rcmeng1q84/event-station/models/concept_Artboard 1.png

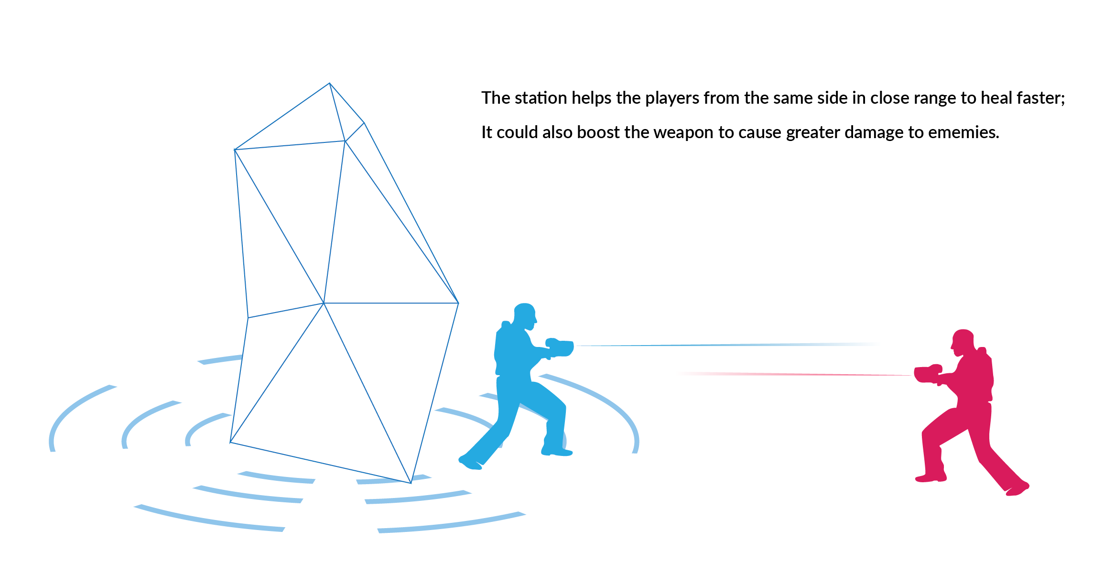
models/concept_Artboard 1.png
