rcmeng1q84/event-station/models/concept_Artboard 4.png

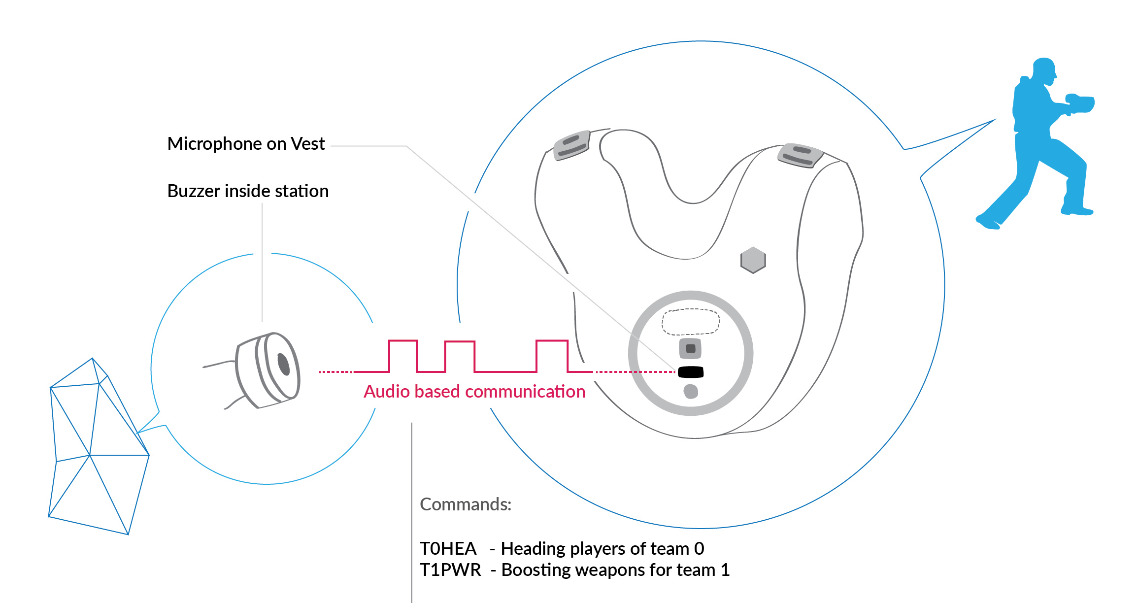
models/concept_Artboard 4.png
