rcmeng1q84/event-station/models/joints.jpg

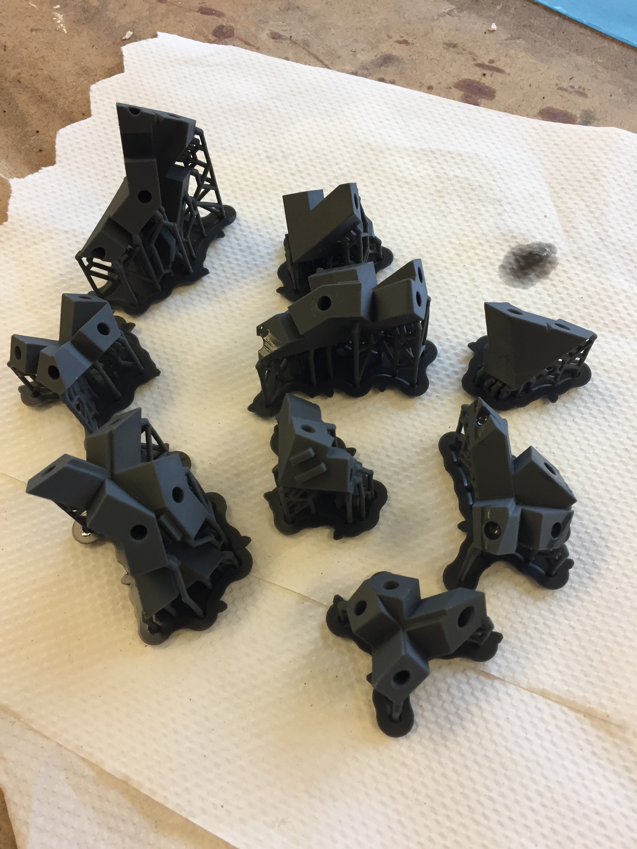
models/joints.jpg
