rcmeng1q84/event-station/models/Photo Dec 12, 18 39 48.jpg

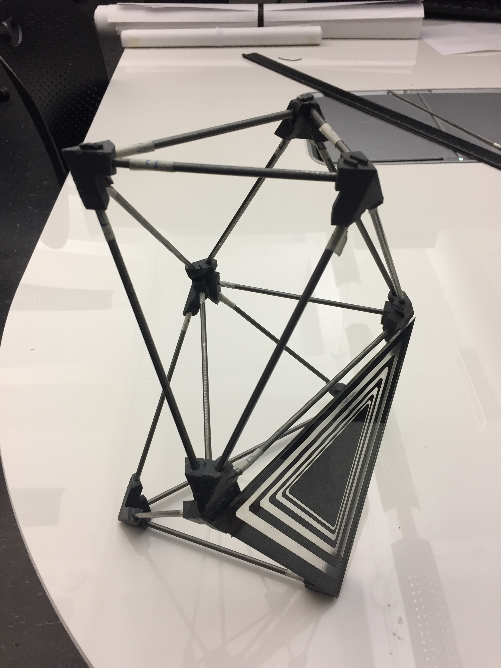
models/Photo Dec 12, 18 39 48.jpg
