rcmeng1q84/event-station/hardware/ST/ST.kicad_pcb

## KiCad design hardware/ST/ST.kicad_pcb (2016-12-15)

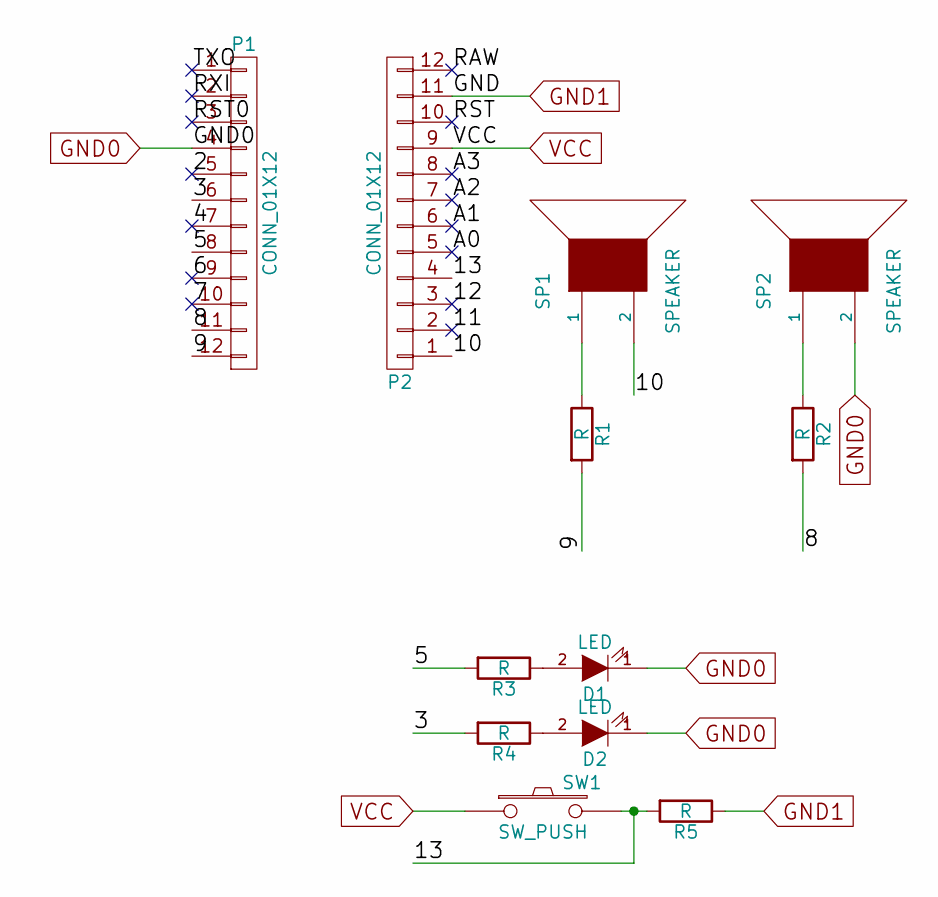
[picture p13: schematic ST.sch]

Parts:
D1, D2: LED; LED-3MM
P1, P2: CONN_01X12; Pin_Header_Straight_1x12
R1, R2, R3, R4, R5: R; R_0805
SP1, SP2: SPEAKER; bornier2
SW1: SW_PUSH; SW_SPST_PTS645

Connections:
/2: P1.5
/3: P1.6, R4.2
/4: P1.7
/5: P1.8, R3.2
/6: P1.9
/7: P1.10
/8: P1.11, R2.2
/9: P1.12, R1.2
/10: P2.1, SP1.2
/11: P2.2
/12: P2.3
/13: P2.4, R5.2, SW1.2
/A0: P2.5
/A1: P2.6
/A2: P2.7
/A3: P2.8
/RAW: P2.12
/RST: P2.10
/RST0: P1.3
/RXI: P1.2
/TXO: P1.1
GND0: D1.1 (K), D2.1 (K), P1.4, SP2.2
GND1: P2.11, R5.1
unnamed: D1.2 (A), R3.1
unnamed: D2.2 (A), R4.1
unnamed: R1.1, SP1.1
unnamed: R2.1, SP2.1
VCC: P2.9, SW1.1

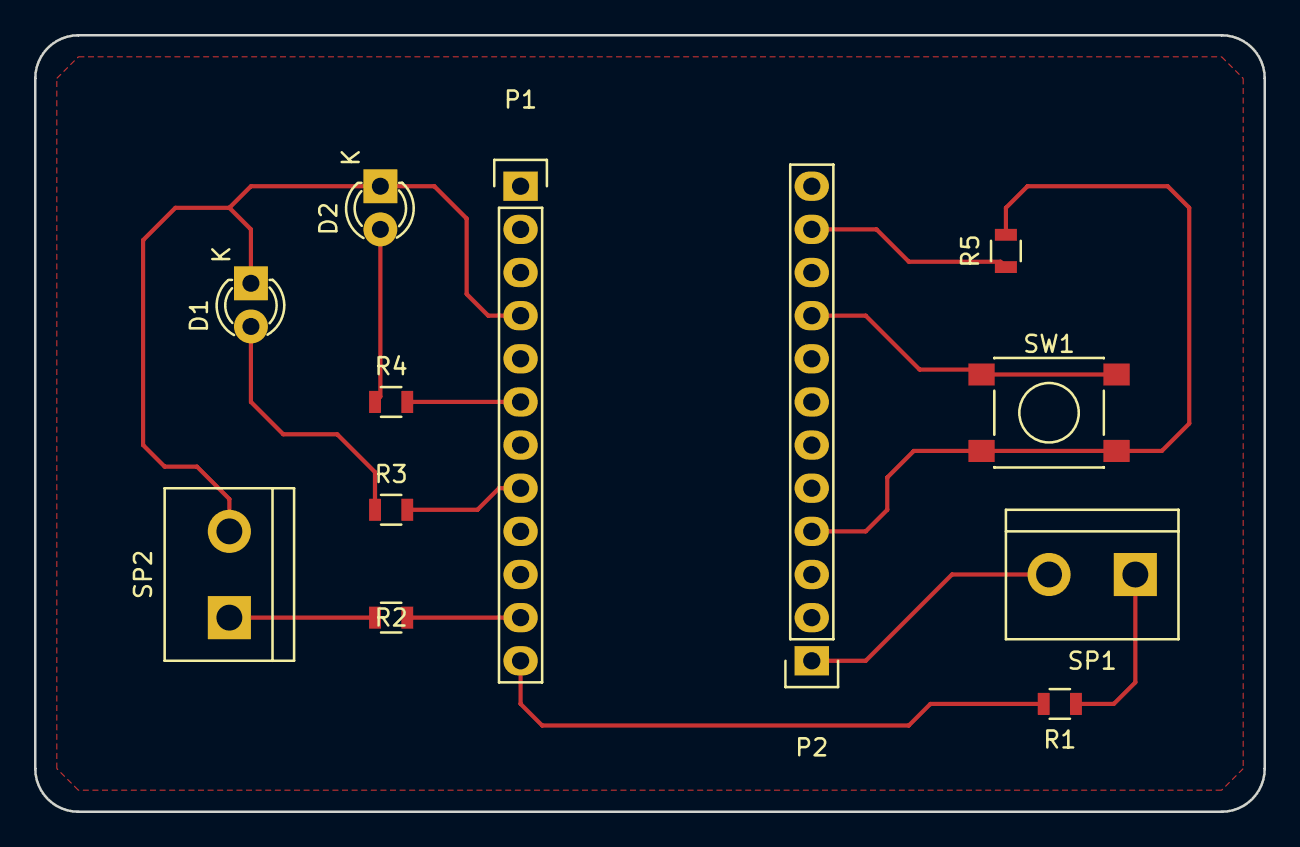
[picture p14: board ST.kicad_pcb from above]

Board: 2 copper layers, 72.4 x 45.7 mm, 12 parts (0 on the bottom side), 13 nets.
