rcmeng1q84/event-station/(commit log)

2016-12-01 [+] basic buzzer experiment.
    [buzzer.ino]
2016-12-14 [+] LED, with fading potential.
2016-12-15 [+] PCB design.
    [ST.kicad_pcb, ST.sch]
2016-12-15 [*] Move stuff.
    [ST.kicad_pcb, ST.sch]
2016-12-15 [+] Euphemism for Arduino Pro Mini.
2016-12-15 [+] Interrupt.
2016-12-15 [+] Emphasis on interrupt.
2016-12-15 [+] Flip by interrupt.
    [buzzer.ino]
2016-12-15 [+] ADC interrupt
2016-12-15 [+] Digital interrupt.
2016-12-17 [+] Explain why 2 LEDs.
2016-12-17 [+] More on digital interrupt hander.
2016-12-17 [+] What we know about ADC interrupt handler.
2016-12-18 [+] Document minor changes to the circuit.
